donalmclaughlin/LateralFlowServerAndFirmware/arduino/temp/09-29-35.bmp

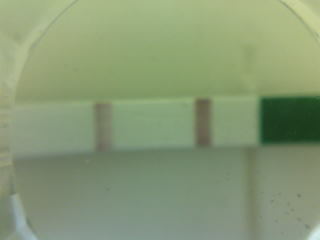
arduino/temp/09-29-35.bmp
