donalmclaughlin/LateralFlowServerAndFirmware/arduino/temp/09-28-31.bmp

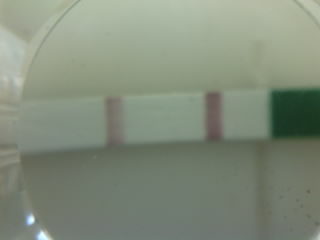
arduino/temp/09-28-31.bmp
