donalmclaughlin/LateralFlowServerAndFirmware/arduino/Connection-Arduino-Arducam.PNG

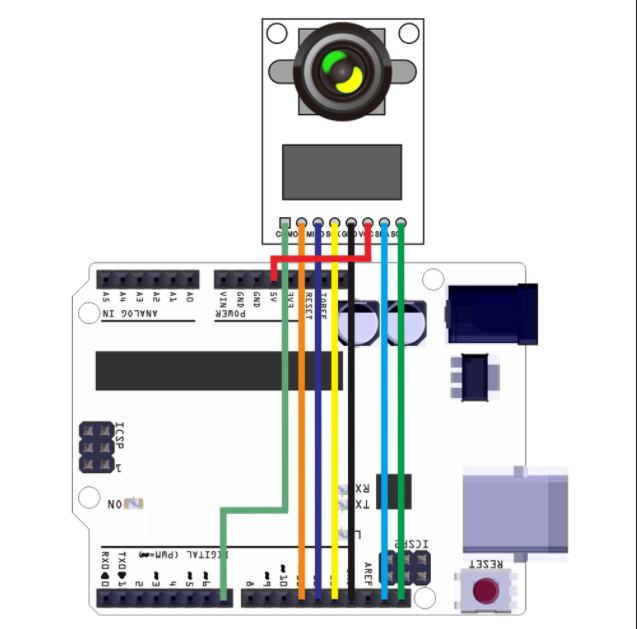
arduino/Connection-Arduino-Arducam.PNG
