donalmclaughlin/LateralFlowServerAndFirmware/arduino/temp/12-57-07.bmp

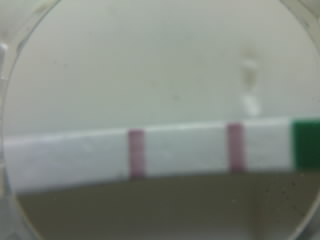
arduino/temp/12-57-07.bmp
