donalmclaughlin/LateralFlowServerAndFirmware/AWS Cloud Structure.jpeg

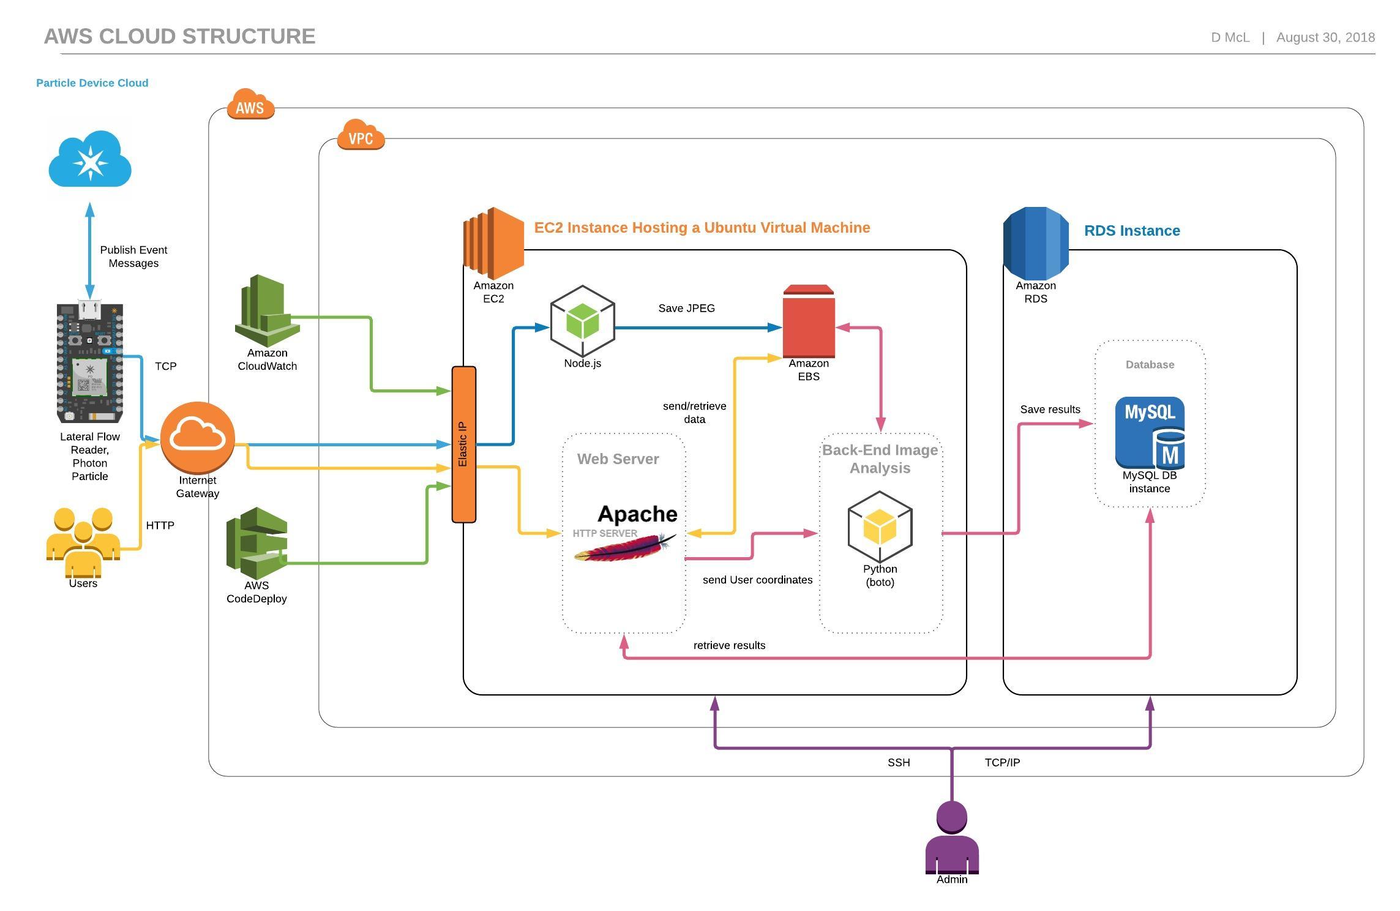
AWS Cloud Structure.jpeg
