donalmclaughlin/LateralFlowServerAndFirmware/CAD/lateralflownote.png

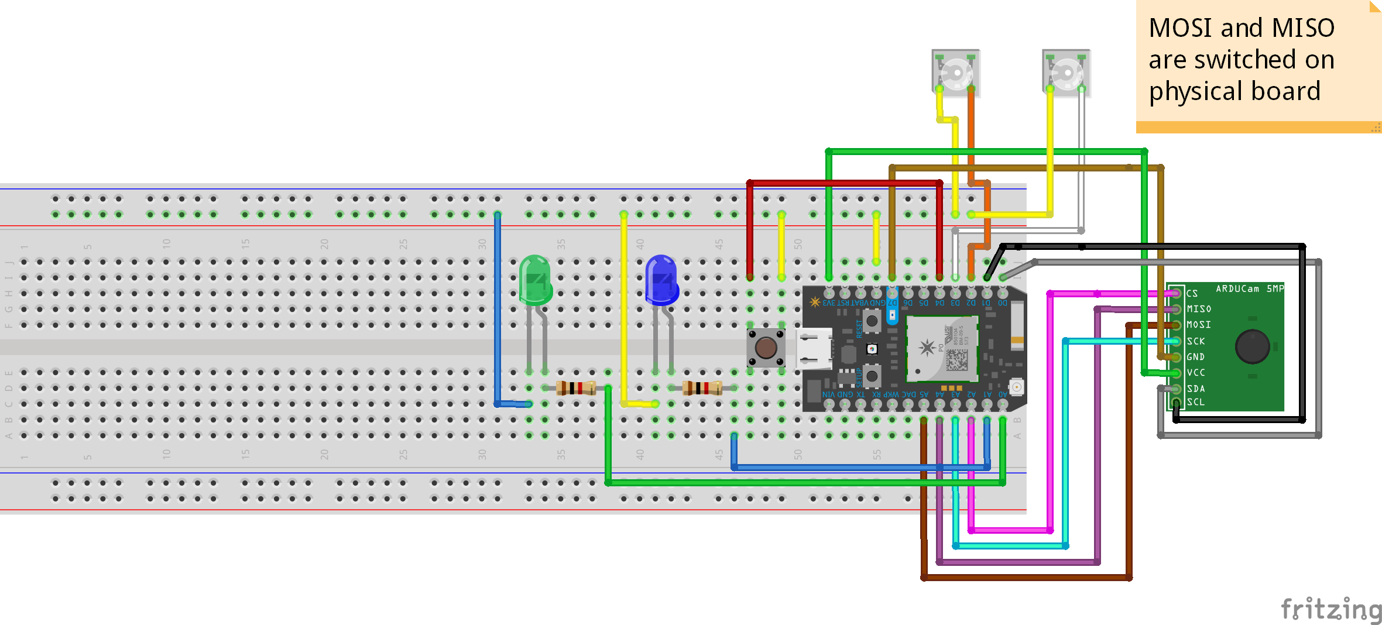
CAD/lateralflownote.png
