donalmclaughlin/LateralFlowServerAndFirmware/CAD/CADsolidedge/LateralFlowCADdesignremoveinnerlidheightincrease.stl

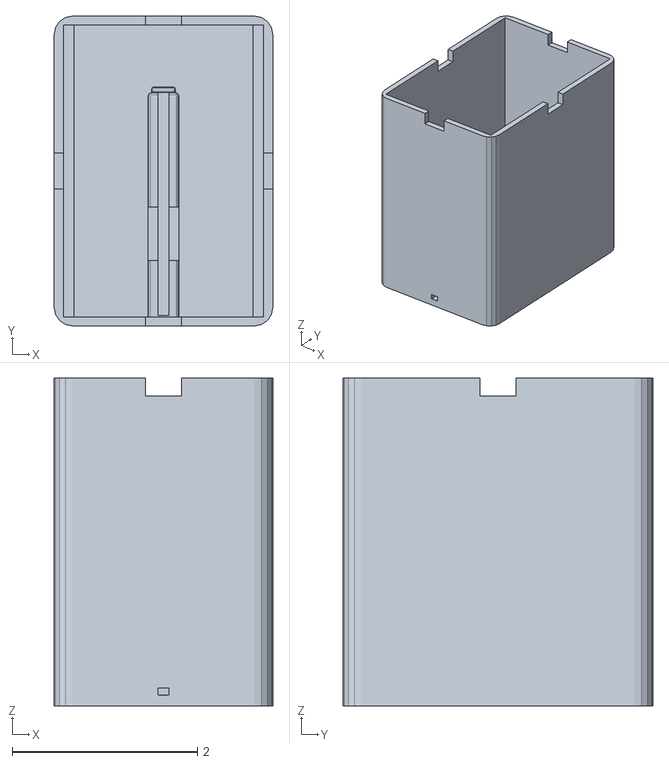
[picture p27: CAD file, 2018-09-11]
CAD/CADsolidedge/LateralFlowCADdesignremoveinnerlidheightincrease.stl
2.36 x 3.35 x 3.54
