donalmclaughlin/LateralFlowServerAndFirmware/CAD/CADsolidedge/LateralFlowCADdesignremoveinnerlid.stl

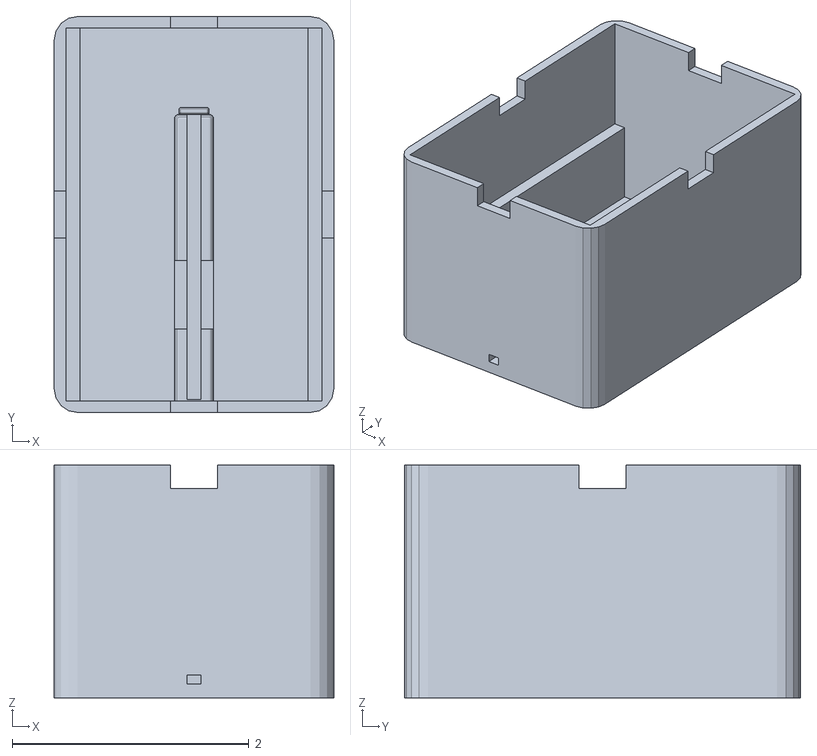
[picture p28: CAD file, 2018-09-11]
CAD/CADsolidedge/LateralFlowCADdesignremoveinnerlid.stl
2.36 x 3.35 x 1.97
