donalmclaughlin/LateralFlowServerAndFirmware/(list of files, drawings)

Other design files:
CAD/lateralflowsketch.fzz
