donalmclaughlin/LateralFlowServerAndFirmware/arduino/arduino-master/arducam/mt9d112_regs.h

#ifndef MT9M112_REGS_H
#define MT9M112_REGS_H
#include "ArduCAM.h"
#include <Wire.h>

const struct sensor_reg MT9T112_QVGA[] PROGMEM=
{
	


	{0xffff, 0xffff},
};

const struct sensor_reg MT9D112_soc_init[]  PROGMEM=
{
	{0x34ce , 0x01a0 },  
	{0x34d0 , 0x6532 },  
	{0x34d2 , 0x3297 },  
	{0x34d4 , 0x9664 },  
	{0x34d6 , 0x4b25 },  
	{0x34d8 , 0x2670 },  
	{0x34da , 0x724c },  
	{0x34dc , 0xff01 },  
	{0x34de , 0x011f },  
	{0x34e6 , 0x00b3 },  
	{0x34ee , 0x0d8f },  
	{0x34f6 , 0x0d6e },  
	{0x3500 , 0xf51c },  
	{0x3508 , 0xfef8 },  
	{0x3510 , 0x212d },  
	{0x3518 , 0x212b },  
	{0x3520 , 0x1f2a },  
	{0x3528 , 0x2934 },  
	{0x3530 , 0x17db },  
	{0x3538 , 0xe7d6 },  
	{0x354c , 0x07c6 },  
	{0x3544 , 0x07ff },  
	{0x355c , 0x051c },  
	{0x3554 , 0x07ff },  
	{0x34e0 , 0x0137 },  
	{0x34e8 , 0x00a8 },  
	{0x34f0 , 0x0e3e },  
	{0x34f8 , 0x0dcb },  
	{0x3502 , 0xf20a },  
	{0x350a , 0xfbe1 },  
	{0x3512 , 0x1c26 },  
	{0x351a , 0x232b },  
	{0x3522 , 0x312e },  
	{0x352a , 0x2121 },  
	{0x3532 , 0xf106 },  
	{0x353a , 0x0c0d },  
	{0x354e , 0x07ff },  
	{0x3546 , 0x0638 },  
	{0x355e , 0x07ff },  
	{0x3556 , 0x0155 },  
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

	{0x338c , 0xa103 },  
	{0x3390 , 0x0005 },  

	{0x338c , 0xa206 },  
	{0x3390 , 0x003c },  
	{0xffff,0xffff},
};        

const struct sensor_reg MT9D112_default_setting[] PROGMEM =
{
	{0x341e , 0x8f09 },  
	{0x341e , 0x8f08 },  
	{0x3044 , 0x0540 },  
	{0x3216 , 0x02cf },  
	{0x321c , 0x0402 },  
	{0x3212 , 0x0001 },  
	{0x341e , 0x8f09 },  
	{0x341c , 0x0114 },  
	{0x341e , 0x8f09 },  
	{0x341e , 0x8f08 },  
	{0x3044 , 0x0540 },  
	{0x3216 , 0x02cf },  
	{0x321c , 0x0402 },  
	{0x3212 , 0x0001 },  
	{0x338c , 0x2703 },  
	{0x3390 , 0x0140 },  
	{0x338c , 0x2705 },  
	{0x3390 , 0x00f0 },  
	{0x338c , 0x2707 },  
	{0x3390 , 0x0640 },  
	{0x338c , 0x2709 },  
	{0x3390 , 0x04b0 },  
	{0x338c , 0x270d },  
	{0x3390 , 0x0000 },  
	{0x338c , 0x270f },  
	{0x3390 , 0x0000 },  
	{0x338c , 0x2711 },  
	{0x3390 , 0x04bd },  
	{0x338c , 0x2713 },  
	{0x3390 , 0x064d },  
	{0x338c , 0x2715 },  
	{0x3390 , 0x0022 },  
	{0x338c , 0x2717 },  
	{0x3390 , 0x2111 },  
	{0x338c , 0x2719 },  
	{0x3390 , 0x046c },  
	{0x338c , 0x271b },  
	{0x3390 , 0x024f },  
	{0x338c , 0x271d },  
	{0x3390 , 0x0102 },  
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
	
	{0xffff,0xffff},
};       
#endif
