donalmclaughlin/LateralFlowServerAndFirmware/arduino/arduino-master/arducam/ov5640_regs.h

#ifndef OV5640_REGS_H
#define OV5640_REGS_H
#include "ArduCAM.h"
//#include <avr/pgmspace.h>

#define OV5640_CHIPID_HIGH 0x300a
#define OV5640_CHIPID_LOW 0x300b

const struct sensor_reg OV5640YUV_Sensor_Dvp_Init[] PROGMEM=
{
		{ 0x4740, 0x20 },
		
		{ 0x4050, 0x6e },
    { 0x4051, 0x8f },
		
		{ 0x3008, 0x42 }, 
		{ 0x3103, 0x03 }, 
		{ 0x3017, 0x7f }, 
		{ 0x3018, 0xff }, 		
		{ 0x302c, 0x02 }, 		
		{ 0x3108, 0x01 }, 	
		{ 0x3630, 0x2e },//2e
		{ 0x3632, 0xe2 }, 
		{ 0x3633, 0x23 },//23 
		{ 0x3621, 0xe0 }, 
		{ 0x3704, 0xa0 }, 
		{ 0x3703, 0x5a }, 
		{ 0x3715, 0x78 }, 
		{ 0x3717, 0x01 }, 
		{ 0x370b, 0x60 }, 
		{ 0x3705, 0x1a }, 
		{ 0x3905, 0x02 }, 
		{ 0x3906, 0x10 }, 
		{ 0x3901, 0x0a }, 
		{ 0x3731, 0x12 }, 
		{ 0x3600, 0x08 }, 
		{ 0x3601, 0x33 }, 
		{ 0x302d, 0x60 }, 
		{ 0x3620, 0x52 }, 
		{ 0x371b, 0x20 }, 
		{ 0x471c, 0x50 }, 
		
		{ 0x3a18, 0x00 }, 
		{ 0x3a19, 0xf8 }, 
		
		{ 0x3635, 0x1c },//1c
		{ 0x3634, 0x40 }, 
		{ 0x3622, 0x01 }, 
 
		{ 0x3c04, 0x28 }, 
		{ 0x3c05, 0x98 }, 
		{ 0x3c06, 0x00 }, 
		{ 0x3c07, 0x08 }, 
		{ 0x3c08, 0x00 }, 
		{ 0x3c09, 0x1c }, 
		{ 0x3c0a, 0x9c }, 
		{ 0x3c0b, 0x40 },  		

		{ 0x3820, 0x41 }, 
		{ 0x3821, 0x01 }, //07

		//windows setup
		{ 0x3800, 0x00 }, 
		{ 0x3801, 0x00 }, 
		{ 0x3802, 0x00 }, 
		{ 0x3803, 0x04 }, 
		{ 0x3804, 0x0a }, 
		{ 0x3805, 0x3f }, 
		{ 0x3806, 0x07 }, 
		{ 0x3807, 0x9b }, 
		{ 0x3808, 0x05 },  
		{ 0x3809, 0x00 }, 
		{ 0x380a, 0x03 }, 
		{ 0x380b, 0xc0 }, 		
		{ 0x3810, 0x00 }, 
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
		{ 0x568a, 0x42 }, 
		{ 0x568b, 0x24 }, 
		{ 0x568c, 0x42 }, 
		{ 0x568d, 0x24 }, 
		{ 0x568e, 0x22 }, 
		{ 0x568f, 0x22 }, 
		
		{ 0x5025, 0x00 }, 
		
		{ 0x3a0f, 0x30 },
		{ 0x3a10, 0x28 }, 
		{ 0x3a1b, 0x30 }, 
		{ 0x3a1e, 0x28 }, 
		{ 0x3a11, 0x61 }, 
		{ 0x3a1f, 0x10 }, 
		
		{ 0x4005, 0x1a },
		{ 0x3406, 0x00 },//awbinit
    { 0x3503, 0x00 },//awbinit
		{ 0x3008, 0x02 }, 
		{ 0xffff, 0xff },		
};



const struct sensor_reg ov5640_vga_preview[] PROGMEM=
{
		// YUV VGA 30fps, night mode 5fps
		// Input Clock = 24Mhz, PCLK = 56MHz
		{ 0x3035, 0x11 }, // PLL
		{ 0x3036, 0x46 }, // PLL
		{ 0x3c07, 0x08 }, // light meter 1 threshold [7:0]
		{ 0x3820, 0x41 }, // Sensor flip off, ISP flip on
		{ 0x3821, 0x01 }, // Sensor mirror on, ISP mirror on, H binning on
		{ 0x3814, 0x31 }, // X INC
		{ 0x3815, 0x31 }, // Y INC
		{ 0x3800, 0x00 }, // HS
		{ 0x3801, 0x00 }, // HS
		{ 0x3802, 0x00 }, // VS
		{ 0x3803, 0x04 }, // VS
		{ 0x3804, 0x0a }, // HW (HE)
		{ 0x3805, 0x3f }, // HW (HE)
		{ 0x3806, 0x07 }, // VH (VE)
		{ 0x3807, 0x9b }, // VH (VE)
		{ 0x3808, 0x02 }, // DVPHO
		{ 0x3809, 0x80 }, // DVPHO
		{ 0x380a, 0x01 }, // DVPVO
		{ 0x380b, 0xe0 }, // DVPVO
		{ 0x380c, 0x07 }, // HTS
		{ 0x380d, 0x68 }, // HTS
		{ 0x380e, 0x03 }, // VTS
		{ 0x380f, 0xd8 }, // VTS
		{ 0x3813, 0x06 }, // Timing Voffset
		{ 0x3618, 0x00 },
		{ 0x3612, 0x29 },
		{ 0x3709, 0x52 },
		{ 0x370c, 0x03 },
		{ 0x3a02, 0x17 }, // 60Hz max exposure, night mode 5fps
		{ 0x3a03, 0x10 }, // 60Hz max exposure
		// banding filters are calculated automatically in camera driver
		//{ 0x3a08, 0x01 }, // B50 step
		//{ 0x3a09, 0x27 }, // B50 step
		//{ 0x3a0a, 0x00 }, // B60 step
		//{ 0x3a0b, 0xf6 }, // B60 step
		//{ 0x3a0e, 0x03 }, // 50Hz max band
		//{ 0x3a0d, 0x04 }, // 60Hz max band
		{ 0x3a14, 0x17 }, // 50Hz max exposure, night mode 5fps
		{ 0x3a15, 0x10 }, // 50Hz max exposure
		{ 0x4004, 0x02 }, // BLC 2 lines
		{ 0x3002, 0x1c }, // reset JFIFO, SFIFO, JPEG
		{ 0x3006, 0xc3 }, // disable clock of JPEG2x, JPEG
		{ 0x4713, 0x03 }, // JPEG mode 3
		{ 0x4407, 0x04 }, // Quantization scale
		{ 0x460b, 0x35 },
		{ 0x460c, 0x22 },
		{ 0x4837, 0x22 }, // DVP CLK divider
		{ 0x3824, 0x02 }, // DVP CLK divider
		{ 0x5001, 0xa3 }, // SDE on, scale on, UV average off, color matrix on, AWB on
		{ 0x3503, 0x00 }, // AEC/AGC on	
		
}; 

const struct sensor_reg OV5640_RGB_QVGA[] PROGMEM =
{
		{0x3008, 0x02},
		{0x3035, 0x41},
		{0x4740, 0x21},
		{0x4300, 0x61},
		{0x3808, 0x01},
		{0x3809, 0x40},
		{0x380a, 0x00},
		{0x380b, 0xf0},
		{0x501f, 0x01}, 
		{0xffff, 0xff},
};       

//2592x1944 QSXGA
const struct sensor_reg OV5640_JPEG_QSXGA[] PROGMEM =
{
		{0x3820 ,0x40}, 
		{0x3821 ,0x26}, 
		{0x3814 ,0x11}, 
		{0x3815 ,0x11}, 
		{0x3803 ,0x00}, 
		{0x3807 ,0x9f}, 
		{0x3808 ,0x0a}, 
		{0x3809 ,0x20}, 
		{0x380a ,0x07}, 
		{0x380b ,0x98},
		{0x380c ,0x0b},                                                                    
		{0x380d ,0x1c}, 
		{0x380e ,0x07},                                                         
		{0x380f ,0xb0},                                                          
		{0x3813 ,0x04},                                                     
		{0x3618 ,0x04},                        
		{0x3612 ,0x4b},                                               
		{0x3708 ,0x64},                
		{0x3709 ,0x12},                                    
		{0x370c ,0x00},  
		{0x3a02 ,0x07},                             
		{0x3a03 ,0xb0},                        
		{0x3a0e ,0x06},                    
		{0x3a0d ,0x08}, 
		{0x3a14 ,0x07}, 
		{0x3a15 ,0xb0}, 
		{0x4001 ,0x02}, 
		{0x4004 ,0x06}, 
		{0x3002 ,0x00}, 
		{0x3006 ,0xff}, 
		{0x3824 ,0x04}, 
		{0x5001 ,0x83}, 
		{0x3036 ,0x69}, 
		{0x3035 ,0x31}, 
		{0x4005 ,0x1A},
		{0xffff, 0xff},	
};

//5MP
const struct sensor_reg OV5640_5MP_JPEG[] PROGMEM =
{
		{0x3800 ,0x00},                            
		{0x3801 ,0x00},                                                            
		{0x3802 ,0x00},                            
		{0x3803 ,0x00},   
		{0x3804 ,0xA },           
		{0x3805 ,0x3f},          
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
		{0x380a ,0x4 },
		{0x380b ,0xb0},
		{0x380c ,0xc },
		{0x380d ,0x80},
		{0x380e ,0x7 },
		{0x380f ,0xd0},
		{0x5001 ,0xa3},
		{0x5680 ,0x0 },
		{0x5681 ,0x0 },
		{0x5682 ,0xA },
		{0x5683 ,0x20},
		{0x5684 ,0x0 },
		{0x5685 ,0x0 },
		{0x5686 ,0x7 },
		{0x5687 ,0x98},
		{0xffff, 0xff},	
};

//1024x768 XGA
const struct sensor_reg OV5640_QSXGA2XGA[] PROGMEM =	
{
		{0x3800 ,0x00},
		{0x3801 ,0x00},
		{0x3802 ,0x00},
		{0x3803 ,0x00},
		{0x3804 ,0xA },
		{0x3805 ,0x3f},
		{0x3806 ,0x7 },
		{0x3807 ,0x9f},
		{0x3808 ,0x4 },
		{0x3809 ,0x0 },
		{0x380a ,0x3 },
		{0x380b ,0x0 },
		{0x380c ,0xc },
		{0x380d ,0x80},
		{0x380e ,0x7 },
		{0x380f ,0xd0},
		{0x5001 ,0xa3},
		{0x5680 ,0x0 },
		{0x5681 ,0x0 },
		{0x5682 ,0xA },
		{0x5683 ,0x20},
		{0x5684 ,0x0 },
		{0x5685 ,0x0 },
		{0x5686 ,0x7 },
		{0x5687 ,0x98},
		{0xffff, 0xff},	
};


#endif
