donalmclaughlin/LateralFlowServerAndFirmware/arduino/arduino-master/arducam/ov5642_regs.h

#ifndef OV5642_REGS_H
#define OV5642_REGS_H
#include "ArduCAM.h"
//#include <avr/pgmspace.h>

#define OV5642_CHIPID_HIGH 0x300a
#define OV5642_CHIPID_LOW 0x300b
const struct sensor_reg ov5642_RAW[] PROGMEM =
{
{0x3103,0x03},
{0x3008,0x82},
{0x3017,0x7f},
{0x3018,0xfc},
{0x3810,0xc2},
{0x3615,0xf0},
{0x3000,0x00},
{0x3001,0x00},
{0x3002,0x00},
{0x3003,0x00},
{0x3011,0x08},
{0x3010,0x30},
{0x3604,0x60},
{0x3622,0x08},
{0x3621,0x17},
{0x3709,0x00},
{0x4000,0x21},
{0x401d,0x02},
{0x3600,0x54},
{0x3605,0x04},
{0x3606,0x3f},
{0x3c01,0x80},
{0x300d,0x21},
{0x3623,0x22},
{0x5000,0xcf},
{0x5001,0xFF},
{0x5020,0x04},
{0x5181,0x79},
{0x5182,0x00},
{0x5185,0x22},
{0x5197,0x01},
{0x5500,0x0a},
{0x5504,0x00},
{0x5505,0x7f},
{0x5080,0x08},
{0x300e,0x18},
{0x4610,0x00},
{0x471d,0x05},
{0x4708,0x06},
{0x3710,0x10},
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

{0xffff,0xff},	
};



const struct sensor_reg OV5642_1280x960_RAW[] PROGMEM =
{
{0x3103,0x93},
{0x3008,0x02},
{0x3017,0x7f},
{0x3018,0xf0},
{0x3615,0xf0},
{0x3000,0xF8},
{0x3001,0x48},
{0x3002,0x5c},
{0x3003,0x02},
{0x3005,0xB7},
{0x3006,0x43},
{0x3007,0x37},
{0x300f,0x06},
{0x3011,0x08},
{0x3010,0x20},
{0x3012,0x00},
{0x460c,0x22},
{0x3815,0x04},
{0x370c,0xA0},
{0x3602,0xFC},
{0x3612,0xFF},
{0x3634,0xC0},
{0x3613,0x00},
{0x3622,0x00},
{0x3603,0x27},
{0x4000,0x21},
{0x401D,0x02},
{0x3600,0x54},
{0x3605,0x04},
{0x3606,0x3F},
{0x5020,0x04},
{0x5197,0x01},
{0x5001,0xFF},
{0x5500,0x10},
{0x5502,0x00},
{0x5503,0x04},
{0x5504,0x00},
{0x5505,0x7F},
{0x5080,0x08},
{0x300E,0x18},
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
	{0x568a ,0xfe},
	{0x568b ,0xef},
	{0x568c ,0xfe},
	{0x568d ,0xef},
	{0x568e ,0xaa},
	{0x568f ,0xaa},



	{0xffff,0xff},
};        

const struct sensor_reg OV5642_JPEG_Capture_QSXGA[] PROGMEM =
{
	// OV5642_ QSXGA _YUV7.5 fps
	// 24 MHz input clock, 24Mhz pclk
	// jpeg mode 7.5fps

	{0x3503 ,0x07},	//AEC Manual Mode Control
	{0x3000 ,0x00},	//SYSTEM RESET00
	{0x3001 ,0x00},	//Reset for Individual Block
	{0x3002 ,0x00},	//Reset for Individual Block
	{0x3003 ,0x00},	//Reset for Individual Block
	{0x3005 ,0xff},	//Clock Enable Control
	{0x3006 ,0xff},	//Clock Enable Control
	{0x3007 ,0x3f},	//Clock Enable Control
	{0x350c ,0x07},	//AEC VTS Output high bits
	{0x350d ,0xd0},	//AEC VTS Output low bits
	{0x3602 ,0xe4},	//Analog Control Registers
	{0x3612 ,0xac},	//Analog Control Registers
	{0x3613 ,0x44},	//Analog Control Registers
	{0x3621 ,0x27},	//Array Control 01
	{0x3622 ,0x08},	//Analog Control Registers
	{0x3623 ,0x22},	//Analog Control Registers
	{0x3604 ,0x60},	//Analog Control Registers	
	{0x3705 ,0xda},	//Analog Control Registers
	{0x370a ,0x80},	//Analog Control Registers
	{0x3801 ,0x8a},	//HS      
	{0x3803 ,0x0a},	//VS      
	{0x3804 ,0x0a},	//HW      
	{0x3805 ,0x20},	//HW      
	{0x3806 ,0x07},	//VH      
	{0x3807 ,0x98},	//VH      
	{0x3808 ,0x0a},	//DVPHO   
	{0x3809 ,0x20},	//DVPHO   
	{0x380a ,0x07},	//DVPVO   
	{0x380b ,0x98},	//DVPVO   
	{0x380c ,0x0c},	//HTS     
	{0x380d ,0x80},	//HTS     
	{0x380e ,0x07},	//VTS     
	{0x380f ,0xd0},	//VTS     
	{0x3810 ,0xc2},
	{0x3815 ,0x44},
	{0x3818 ,0xc8},	//Mirror NO, Compression enable
	{0x3824 ,0x01},	//RSV 
	{0x3827 ,0x0a},	//RSV
	{0x3a00 ,0x78},	//AEC System Control 0
	{0x3a0d ,0x10},	//60 Hz Max Bands in One Frame
	{0x3a0e ,0x0d},	//50 Hz Max Bands in One Frame
	{0x3a10 ,0x32},	//Stable Range Low Limit (enter)
	{0x3a1b ,0x3c},	//Stable Range High Limit (go out)
	{0x3a1e ,0x32},	//Stable Range Low Limit (go out)
	{0x3a11 ,0x80},	//Step Manual Mode, Fast Zone High Limit
	{0x3a1f ,0x20},	//Step Manual Mode, Fast Zone Low Limit
	{0x3a00 ,0x78},	//AEC System Control 0
	{0x460b ,0x35},	//RSV VFIFO Control 0B
	{0x471d ,0x00},	//DVP CONTROL 1D
	{0x4713 ,0x03},	//COMPRESSION MODE SELECT mode3
	{0x471c ,0x50},	//RSV
	{0x5682 ,0x0a},	//AVG X END
	{0x5683 ,0x20},	//AVG X END
	{0x5686 ,0x07},	//AVG Y END
	{0x5687 ,0x98},	//AVG Y END
	{0x5001 ,0x4f},	//ISP CONTROL 01, UV adjust/Line stretch/UV average/Color matrix/AWB enable
	{0x589b ,0x00}, //RSV
	{0x589a ,0xc0},	//RSV
	{0x4407 ,0x08},	//COMPRESSION CTRL07 Bit[5:0]: Quantization scale  0x02
	{0x589b ,0x00},	//RSV
	{0x589a ,0xc0},	//RSV
	{0x3002 ,0x0c},	//Reset for Individual Block, Reset SFIFO/compression
	{0x3002 ,0x00},	//Reset for Individual Block
	{0x3503 ,0x00},	//AEC Manual Mode Control, Auto enable
	//{0x3818, 0xa8},
	//{0x3621, 0x17},
	//{0x3801, 0xb0},
	{0x5025, 0x80},
	{0x3a0f, 0x48},
	{0x3a10, 0x40},
	{0x3a1b, 0x4a},
	{0x3a1e, 0x3e},
	{0x3a11, 0x70},
	{0x3a1f, 0x20},
	{0xffff, 0xff},

};


const struct sensor_reg OV5642_1080P_Video_setting[] PROGMEM = 
{
	{0x3103 ,0x93},
	{0x3008 ,0x82},
	{0x3017 ,0x7f},
	{0x3018 ,0xfc},
	{0x3810 ,0xc2},
	{0x3615 ,0xf0},
	{0x3000 ,0x00},
	{0x3001 ,0x00},
	{0x3002 ,0x00},
	{0x3003 ,0x00},
	{0x3004 ,0xff},
	{0x3030 ,0x0b},
	{0x3011 ,0x08},
	{0x3010 ,0x10},
	{0x3604 ,0x60},
	{0x3622 ,0x60},
	{0x3621 ,0x09},
	{0x3709 ,0x00},
	{0x4000 ,0x21},
	{0x401d ,0x22},
	{0x3600 ,0x54},
	{0x3605 ,0x04},
	{0x3606 ,0x3f},
	{0x3c01 ,0x80},
	{0x300d ,0x22},
	{0x3623 ,0x22},
	{0x5000 ,0x4f},
	{0x5020 ,0x04},
	{0x5181 ,0x79},
	{0x5182 ,0x00},
	{0x5185 ,0x22},
	{0x5197 ,0x01},
	{0x5500 ,0x0a},
	{0x5504 ,0x00},
	{0x5505 ,0x7f},
	{0x5080 ,0x08},
	{0x300e ,0x18},
	{0x4610 ,0x00},
	{0x471d ,0x05},
	{0x4708 ,0x06},
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

	{0x5800 ,0x48},
	{0x5801 ,0x31},
	{0x5802 ,0x21},
	{0x5803 ,0x1b},
	{0x5804 ,0x1a},
	{0x5805 ,0x1e},
	{0x5806 ,0x29},
	{0x5807 ,0x38},
	{0x5808 ,0x26},
	{0x5809 ,0x17},
	{0x580a ,0x11},
	{0x580b ,0xe },
	{0x580c ,0xd },
	{0x580d ,0xe },
	{0x580e ,0x13},
	{0x580f ,0x1a},
	{0x5810 ,0x15},
	{0x5811 ,0xd },
	{0x5812 ,0x8 },
	{0x5813 ,0x5 },
	{0x5814 ,0x4 },
	{0x5815 ,0x5 },
	{0x5816 ,0x9 },
	{0x5817 ,0xd },
	{0x5818 ,0x11},
	{0x5819 ,0xa },
	{0x581a ,0x4 },
	{0x581b ,0x0 },
	{0x581c ,0x0 },
	{0x581d ,0x1 },
	{0x581e ,0x6 },
	{0x581f ,0x9 },
	{0x5820 ,0x12},
	{0x5821 ,0xb },
	{0x5822 ,0x4 },
	{0x5823 ,0x0 },
	{0x5824 ,0x0 },
	{0x5825 ,0x1 },
	{0x5826 ,0x6 },
	{0x5827 ,0xa },
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

	{0x5180 ,0xff},
	{0x5181 ,0x52},
	{0x5182 ,0x11},
	{0x5183 ,0x14},
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
	{0x54B2 ,0x00},
	{0x54B3 ,0x10}, 
	{0x54B4 ,0x00},
	{0x54B5 ,0xf0}, 
	{0x54B6 ,0x00},
	{0x54B7 ,0xDF}, 
	              
	{0x5402 ,0x3f}, 
	{0x5403 ,0x00},
	      
	{0x5500 ,0x10},
	{0x5502 ,0x00},
	{0x5503 ,0x06},
	{0x5504 ,0x00},
	{0x5505 ,0x7f},
	              
	{0x5025 ,0x80},
	{0x3a0f ,0x30},
	{0x3a10 ,0x28},
	{0x3a1b ,0x30},
	{0x3a1e ,0x28},
	{0x3a11 ,0x61},
	{0x3a1f ,0x10},
	{0x5688 ,0xfd},
	{0x5689 ,0xdf},
	{0x568a ,0xfe},
	{0x568b ,0xef},
	{0x568c ,0xfe},
	{0x568d ,0xef},
	{0x568e ,0xaa},
	{0x568f ,0xaa}, 
	{0x3818, 0xa8},
	{0x3621, 0x27},                 
	{0xffff, 0xff},	
	
};

#endif
