donalmclaughlin/LateralFlowServerAndFirmware/arduino/arduino-master/arducam/ov3640_regs.h

#ifndef OV3640_REGS_H
#define OV3640_REGS_H
#include "ArduCAM.h"

#define OV3640_CHIPID_HIGH 	0x300a
#define OV3640_CHIPID_LOW 	0x300b

//#include <avr/pgmspace.h>
const struct sensor_reg OV3640_VGA[] PROGMEM =
{
 {0x3012, 0x80},
 {0x3012, 0x80},
 {0x304d, 0x45},
 {0x3087, 0x16},
 {0x30aa, 0x45},
 {0x30b0, 0xff},
 {0x30b1, 0xff},
 {0x30b2, 0x10},
 {0x30d7, 0x10},
 {0x309e, 0x00},
 {0x3602, 0x26},
 {0x3603, 0x4D},
 {0x364c, 0x04},
 {0x360c, 0x12},
 {0x361e, 0x00},
 {0x361f, 0x11},
 {0x3633, 0x32},
 {0x3629, 0x3c},
 {0x300e, 0x32},
 {0x300f, 0x21},
 {0x3010, 0x21},
 {0x3011, 0x00},
 {0x304c, 0x81},
 {0x3018, 0x58},
 {0x3019, 0x59},
 {0x301a, 0x61},
 {0x307d, 0x00},
 {0x3087, 0x02},
 {0x3082, 0x20},
 {0x303c, 0x08},
 {0x303d, 0x18},
 {0x303e, 0x06},
 {0x303F, 0x0c},
 {0x3030, 0x62},
 {0x3031, 0x26},
 {0x3032, 0xe6},
 {0x3033, 0x6e},
 {0x3034, 0xea},
 {0x3035, 0xae},
 {0x3036, 0xa6},
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
 
};




const struct sensor_reg OV3640_QVGA[] PROGMEM =
{
	{0x3012, 0x80}, 
	{0x304d, 0x45}, 
	{0x30a7, 0x5e}, 
	{0x3087, 0x16}, 
	{0x309c, 0x1a}, 
	{0x30a2, 0xe4}, 
	{0x30aa, 0x42}, 
	{0x30b0, 0xff}, 
	{0x30b1, 0xff}, 
	{0x30b2, 0x10}, 
	{0x300e, 0x32}, 
	{0x300f, 0x21}, 
	{0x3010, 0x20}, 
	{0x3011, 0x04}, 
	{0x304c, 0x81}, 
	{0x30d7, 0x10}, 
	{0x30d9, 0x0d}, 
	{0x30db, 0x08}, 
	{0x3016, 0x82}, 
	{0x3018, 0x58}, 
	{0x3019, 0x59}, 
	{0x301a, 0x61}, 
	{0x307d, 0x00}, 
	{0x3087, 0x02}, 
	{0x3082, 0x20}, 
	{0x3015, 0x12}, 
	{0x3014, 0x84}, 
	{0x3013, 0xf7}, 
	{0x303c, 0x08}, 
	{0x303d, 0x18}, 

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
};

const struct sensor_reg OV3640_2048x1536_JPEG[] PROGMEM =
{
	{0x3302, 0xef},
	{0x335f, 0x68},
	{0x3360, 0x18},
	{0x3361, 0x0c},
	{0x3362, 0x68},
	{0x3363, 0x08},
	{0x3364, 0x04},
	{0x3403, 0x42},
	{0x3088, 0x08},
	{0x3089, 0x00},
	{0x308a, 0x06},
	{0x308b, 0x00},
	
	{0xffff,0xff},
};

#endif
