donalmclaughlin/LateralFlowServerAndFirmware/arduino/arduino-master/arducam/ov7670_regs.h

#ifndef OV7670_REGS_H
#define OV7670_REGS_H
#include "ArduCAM.h"
//#include <avr/pgmspace.h>
const struct sensor_reg OV7670_QVGA[] PROGMEM =
{
	{0x3a, 0x04},
    {0x40, 0xd0},
    {0x12, 0x14},
    {0x32, 0x80},
    {0x17, 0x16},
    {0x18, 0x04},
    {0x19, 0x02},
    {0x1a, 0x7b},
    {0x03, 0x06},
    {0x0c, 0x00},
    {0x3e, 0x00},
    {0x70, 0x00},
    {0x71, 0x00},
    {0x72, 0x11},
    {0x73, 0x00},
    {0xa2, 0x02},
    {0x11, 0x81},
    {0x7a, 0x20},
    {0x7b, 0x1c},
    {0x7c, 0x28},
    {0x7d, 0x3c},
    {0x7e, 0x55},
    {0x7f, 0x68},
    {0x80, 0x76},
    {0x81, 0x80},
    {0x82, 0x88},
    {0x83, 0x8f},
    {0x84, 0x96},
    {0x85, 0xa3},
    {0x86, 0xaf},
    {0x87, 0xc4},
    {0x88, 0xd7},
    {0x89, 0xe8},
    {0x13, 0xe0},
    {0x00, 0x00},
    {0x10, 0x00},
    {0x0d, 0x00},
    {0x14, 0x28},
    {0xa5, 0x05},
    {0xab, 0x07},
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
};        


#endif
