donalmclaughlin/LateralFlowServerAndFirmware/arduino/arduino-master/arducam/ov7660_regs.h

#ifndef OV7660_REGS_H
#define OV7660_REGS_H
#include "ArduCAM.h"
//#include <avr/pgmspace.h>
const struct sensor_reg OV7660_QVGA[] PROGMEM =
{
	{0x11, 0x83},   
    {0x92, 0x48},   
    {0x93, 0x00},   
    {0x9d, 0x31},   
    {0x9e, 0x29},   
    {0x3b, 0x02},   
    {0x13, 0xf2},   
    {0x10, 0x00},   
    {0x00, 0x00},   
    {0x01, 0x80},   
    {0x02, 0x80},   
    {0x13, 0xf7},   
    {0x12, 0x14},   
    {0x04, 0x00},   
    {0x18, 0x4b},   
    {0x17, 0x23},   
    {0x32, 0xbf},   
    {0x19, 0x02},   
    {0x1a, 0x7a},   
    {0x03, 0x00},   
    {0x0e, 0x84},   
    {0x0f, 0x62},   
    {0x15, 0x02},   
    {0x16, 0x02},   
    {0x1b, 0x01},   
    {0x1e, 0x01},   
    {0x29, 0x3c},   
    {0x33, 0x00},   
    {0x34, 0x07},   
    {0x35, 0x84},   
    {0x36, 0x00},   
    {0x38, 0x13},   
    {0x39, 0x43},   
    {0x3a, 0x00},   
    {0x3c, 0x6c},   
    {0x3d, 0x90},   
    {0x3f, 0x29},   
    {0x40, 0xd1},   
    {0x41, 0x20},   
    {0x6b, 0x0a},   
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
};        


#endif
