donalmclaughlin/LateralFlowServerAndFirmware/arduino/arduino-master/arducam/ov7675_regs.h

#ifndef OV7675_REGS_H
#define OV7675_REGS_H
#include "ArduCAM.h"
//#include <avr/pgmspace.h>
#define OV7675_CHIPID_HIGH 	0x0A
#define OV7675_CHIPID_LOW 	0x0B
const struct sensor_reg OV7675_QVGA[] PROGMEM =
{
	{0x11,0x80},
	{0x3a,0x4},
	{0x12,0x0},
	{0x17,0x13},
	{0x18,0x1},
	{0x32,0xb6},
	{0x19,63},
	{0x1a,0x7b},
	{0x03,0x01},	
	{0xc,0x0},
	{0x3e,0x0},
	{0x70,0x3a},
	{0x71,0x35},
	{0x72,0x11},
	{0x73,0xf0},
	{0xa2,0x2},
	{0x15,0x0},
	{0x7a,0x18},
	{0x7b,0x4},
	{0x7c,0x9},
	{0x7d,0x18},
	{0x7e,0x38},
	{0x7f,0x47},
	{0x80,0x56},
	{0x81,0x66},
	{0x82,0x74},
	{0x83,0x7f},
	{0x84,0x89},
	{0x85,0x9a},
	{0x86,0xa9},
	{0x87,0xc4},
	{0x88,0xdb},
	{0x89,0xee},
	{0x13,0xe0},
	{0x1,0x50},
	{0x2,0x68},
	{0x0,0x0},
	{0x10,0x0},
	{0xd,0x40},
	{0x14,0x48},
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
};        


#endif
